eSpark-Consulting-Group/zachary-turner-smart-lighter-hw/docs/Client-Files/Smart Lighter Design.docx

### Detailed Design

1. Clip Attachment:
  - Design: A robust clip mechanism that securely attaches the smart device to the bong’s 14mm or 18mm cylindrical tube just before where the bowl is inserted.
  - Material: Durable, heat-resistant materials such as anodized aluminum or reinforced polymer, ensuring durability and a sleek look.
2. Butane Container:
  - Integration: A cylindrical butane container integrated into the body of the smart device.
  - Safety: Safety valves and pressure release mechanisms to ensure safe operation.
3. Articulated Stove Lighter:
  - Design: A 4-5 inch articulated arm that allows precise control over the flame’s position. The arm is adjustable for optimal user experience. (think of stove lighter) Can also make this location an attachment to potentially swap between different size stove lighter lengths
  - Metal Covering: A larger, spring-loaded metal cover that flips open and closed, similar to mini torches.
  - Dual Function: The metal cover doubles as a tool to extinguish the flame in the bowl if the user needs to put out the cherry.
  - Spring Mechanism: A reliable spring mechanism for smooth operation to flip back and forth from closed/open.
4. Capacitive Touch Sensor:
  - Placement: Integrated into the metal covering of the stove lighter.
  - Functionality: Touching the sensor ignites the flame and emits the butane. Releasing the sensor turns off the flame.
  - Safety: Ensure the capacitive touch sensor is responsive and activates only with intentional touch. (2 second delay?)
5. Binary 10 LED Display:
  - Display Information: Number of puffs or lights of the lighter, battery life, and other information during use through blinking.
  - Placement: Positioned on the body of the smart device for easy visibility.

### Additional Improvements

1. Integrated Features:
  - Status Indicators: LED indicators for butane level, flame activation, and other statuses.
  - Aesthetics: Seamless integration of LEDs to maintain a sleek design.
2. Bluetooth Connectivity (Optional):
  - App Control: (Optional) Allow users to control the lighter and monitor statistics through a smartphone app.
  - Customization: Users can set preferences for flame duration, temperature thresholds, and receive alerts.
3. Rechargeable Battery:
  - Power Source: A rechargeable battery powers the capacitive touch sensor, LCD screen, and other electronic components.
  - Charging Port: Discreet charging port on the device for easy recharging, possibly USB-C for modern compatibility.
4. WaterProof (Optional)

### Step-by-Step Plan for Prototyping

#### 1. Design the Custom Components

- Tip for Lighter Head:
  - Design a threaded fitting that securely attaches to the lighter head.
  - Ensure the fitting matches the threading on the gooseneck tubing and the lighter head.
  - Consider including heat-resistant materials or coatings to handle the lighter's heat.
- Clip:
  - Design the clip that will attach to the bong.
  - Include mounting points for the gooseneck tubing and the custom clamp.
  - Ensure the clip is robust and can securely hold the articulating arm.
- Custom Clamp:
  - Design a clamp that can hold the smooth end of the gooseneck tubing.
  - Ensure the clamp provides a quick-release mechanism for easy detachment and adjustment.
  - Use materials that provide both strength and flexibility.

#### 2. Create Detailed CAD Models

- Use CAD software to create detailed models of the tip, clip, and clamp.
- Ensure all dimensions are accurate and consider any tolerances required for a secure fit.

#### 3. Machining or 3D Printing the Prototypes

- Materials:
  - Use aluminum or stainless steel for durability and heat resistance.
  - Consider 3D printing for initial prototypes to quickly test fit and function before final machining.
- Manufacturing:
  - Machine the components using CNC machining for precision.
  - Alternatively, use 3D printing for the initial prototypes to validate the design.

#### 4. Assembly and Testing

- Assemble the Components:
  - Attach the threaded tip to the lighter head.
  - Secure the gooseneck tubing to the clip using the custom clamp.
  - Ensure all connections are tight and secure.
- Test the Functionality:
  - Verify the stability and flexibility of the articulating arm.
  - Test the lighter head for proper ignition and flame control.
  - Ensure the quick-release mechanism on the clamp functions as expected.
- Validate the Design:
  - Check for any issues with fit, alignment, or interference.
  - Make adjustments to the design as needed based on the testing results.

Given the constraint of only having access to approximately 65% of the circle, we need to ensure the clamp mechanism can securely tighten and hold without requiring access behind the tube. We can use a hinged design with a cam lock or quick-release mechanism integrated into the accessible part of the clamp.

### Clamp Design

#### Key Features

1. Half-Circle Clamp with Extension: Covers approximately 65% of the tube’s circumference.
2. Hinged Design: One side of the clamp is hinged to allow it to open and close around the tube.
3. Cam Lock Lever or Quick-Release Mechanism: Located on the accessible part of the clamp for tightening and releasing.
4. Main Mounting Point For Lighter: This will be the only thing holding and stabilizing the lighter. It will be machined and the butane container will be incorporated into the design.

### Design Components

1. Clamp Body: Anodized aluminum or stainless steel, shaped to cover 65% of the tube’s circumference.
2. Hinge: Allows one side of the clamp to open and close.
3. Protective Inserts: Silicone or rubber inserts to cushion the glass.
4. Cam Lock Lever or Quick-Release Mechanism: For easy tightening and releasing of the clamp.

### Detailed Design Steps

#### 1. Half-Circle Clamp Body

- Shape: A half-circle with an additional extension to cover 65% of the circumference.
- Material: Anodized aluminum or stainless steel.
- Width: Approximately 1 inch for even pressure distribution.

#### 2. Hinge

- Design: A hinge on one side of the clamp to allow it to open and close.
- Material: Stainless steel or similar durable material.

#### 3. Protective Inserts

- Material: Silicone or rubber.
- Placement: Line the inside of the clamp to cushion the glass.

#### 4. Cam Lock Lever or Quick-Release Mechanism

- Location: On the accessible part of the clamp.
- Function: Allows for tightening and securing the clamp around the tube.

### How the Mechanism Works

1. Initial Position:
  - The clamp is open, allowing it to be placed around the glass tube.
  - The hinge allows the clamp to open wide enough to fit around the tube.
2. Engaging the Mechanism:
  - The clamp is closed around the tube.
  - The cam lock lever or quick-release mechanism is engaged to tighten the clamp.
3. Securing the Clamp:
  - The cam lock lever or quick-release mechanism pulls the clamp tight around the tube.
  - The silicone or rubber inserts provide cushioning and a secure grip.
4. Quick Release:
  - To detach, the cam lock lever or quick-release mechanism is released.
  - The hinge allows the clamp to open and be removed easily.

### Example Configuration

1. Clamp Body:
  - Half-circle with an additional 10-15% extension, covering 65% of the tube’s circumference.
  - Width of approximately 1 inch.
2. Inserts:
  - Silicone or rubber lining the inside of the clamp.
3. Hinge:
  - Located on one side of the clamp to allow opening and closing.
4. Cam Lock Lever or Quick-Release Mechanism:
  - Located on the accessible part of the clamp for tightening and releasing.

### Components and Power Consumption

1. ATtiny85 Microcontroller
  - Active Mode: Approximately 5mA at 5V
  - Sleep Mode: Approximately 0.1μA in power-down mode
2. TTP223 Touch Sensor
  - Active Mode: Approximately 3mA at 5V
  - Sleep Mode: Approximately 2.5μA
3. LEDs
  - Forward Voltage (Vf): Approximately 2V
  - Current per LED (I): 10mA (typical)
  - Number of LEDs: 10
4. MAX17043 Battery Monitor
  - Active Mode: Approximately 50μA
  - Sleep Mode: Not significant (consumed with the microcontroller)
1. Active Time:
  - Lighter Usage: 5 seconds
  - Battery Blink: 3 times, each blink 0.25 seconds on and 0.25 seconds off, totaling 1.5 seconds (1.25 seconds on time)
  - Total Active Time per Use: 5 seconds + 1.25 seconds = 6.25 seconds
2. Usage Frequency:
  - Once every 30 to 60 minutes, average every 45 minutes.
  - Active period within a day: 9am to 10pm (13 hours)
3. Daily Activations:
  - Number of activations: 13 hours×60 minutes45 minutes\frac{13 \text{ hours} \times 60 \text{ minutes}}{45 \text{ minutes}}45 minutes13 hours×60 minutes
  - Approximate number of activations: 78045≈17.3\frac{780}{45} \approx 17.345780 ≈17.3

### Power Consumption Calculation

1. Sleep Mode Power Consumption:
  - ATtiny85: 0.1μA
  - TTP223: 2.5μA
  - MAX17043: 50μA
  - Total Sleep Current: 0.1μA+2.5μA+50μA=52.6μA0.1μA + 2.5μA + 50μA = 52.6μA0.1μA+2.5μA+50μA=52.6μA
2. Active Mode Power Consumption:
  - ATtiny85: 5mA
  - TTP223: 3mA
  - MAX17043: 50μA
  - LEDs: 10 LEDs ×\times× 10mA = 100mA
  - Total Active Current: 5mA+3mA+0.05mA+100mA=108.05mA5mA + 3mA + 0.05mA + 100mA = 108.05mA5mA+3mA+0.05mA+100mA=108.05mA
3. Duty Cycle Calculation:
  - Total Active Time per Day: 17.3×6.25 seconds=108.125 seconds17.3 \times 6.25 \text{ seconds} = 108.125 \text{ seconds}17.3×6.25 seconds=108.125 seconds
  - Total Day Time: 13 hours×3600 seconds/hour=46800 seconds13 \text{ hours} \times 3600 \text{ seconds/hour} = 46800 \text{ seconds}13 hours×3600 seconds/hour=46800 seconds
  - Duty Cycle: 108.125 seconds46800 seconds≈0.00231\frac{108.125 \text{ seconds}}{46800 \text{ seconds}} \approx 0.0023146800 seconds108.125 seconds ≈0.00231
4. Average Current Consumption:

Average Current=(Sleep Current×(1−Duty Cycle))+(Active Current×Duty Cycle)\text{Average Current} = (\text{Sleep Current} \times (1 - \text{Duty Cycle})) + (\text{Active Current} \times \text{Duty Cycle})Average Current=(Sleep Current×(1−Duty Cycle))+(Active Current×Duty Cycle) Average Current=(52.6μA×(1−0.00231))+(108.05mA×0.00231)\text{Average Current} = (52.6\text{μA} \times (1 - 0.00231)) + (108.05\text{mA} \times 0.00231)Average Current=(52.6μA×(1−0.00231))+(108.05mA×0.00231) Average Current=(52.6μA×0.99769)+(108.05mA×0.00231)\text{Average Current} = (52.6\text{μA} \times 0.99769) + (108.05\text{mA} \times 0.00231)Average Current=(52.6μA×0.99769)+(108.05mA×0.00231) Average Current=52.48μA+0.249mA=0.30148mA\text{Average Current} = 52.48\text{μA} + 0.249\text{mA} = 0.30148\text{mA}Average Current=52.48μA+0.249mA=0.30148mA

### Battery Life Calculation

#### Using a Coin Cell Battery (CR2032)

- Capacity: 200mAh

Battery Life:

Battery Life=CapacityAverage Current=200mAh0.30148mA≈663 hours≈27.6 days\text{Battery Life} = \frac{\text{Capacity}}{\text{Average Current}} = \frac{200\text{mAh}}{0.30148\text{mA}} \approx 663\text{ hours} \approx 27.6\text{ days}Battery Life=Average CurrentCapacity =0.30148mA200mAh ≈663 hours≈27.6 days

#### Using a Rechargeable LiPo Battery

- Capacity: 500mAh (example)

Battery Life:

Battery Life=CapacityAverage Current=500mAh0.30148mA≈1658 hours≈69 days\text{Battery Life} = \frac{\text{Capacity}}{\text{Average Current}} = \frac{500\text{mAh}}{0.30148\text{mA}} \approx 1658\text{ hours} \approx 69\text{ days}Battery Life=Average CurrentCapacity =0.30148mA500mAh ≈1658 hours≈69 days

### Conclusion

With the revised usage scenario, the estimated battery life for your device is approximately:

- 27.6 days with a CR2032 coin cell battery.
- 69 days with a 500mAh rechargeable LiPo battery.

These estimates indicate a significant improvement in battery life due to the reduced duty cycle. This approach ensures that the device can operate efficiently with minimal power consumption.

To implement a low-power solution that wakes up the device from sleep mode upon a capacitive touch trigger, displays the next binary value, blinks the battery level, and then goes back to sleep, we need to focus on a few key components and techniques:

1. ATtiny85 Sleep Mode and Wake-Up
2. Capacitive Touch Sensor
3. Battery Monitoring
4. Power Management and LED Control

### Components

1. ATtiny85 Microcontroller
  - Low-power mode: Sleep mode with wake-up on interrupt.
  - Supplier: Digi-Key
2. Capacitive Touch Sensor
  - Example: TTP223 Capacitive Touch Sensor Module
  - Supplier: Amazon (https://www.amazon.com/TTP223-Capacitive-Touch-Sensor-Module/dp/B08BZK4RXK)
3. Battery Monitor
  - Example: MAX17043 LiPo Fuel Gauge
  - Supplier: Adafruit
4. LEDs and Resistors
  - 0603 SMD LEDs and 0603 Resistors as previously specified.

### Circuit Design

#### Schematic Diagram

plaintext

Copy code

+Vcc
|
220Ω
|
PB0 ---------- LED1 (Bit 0)
|
GND

+Vcc
|
220Ω
|
PB1 ---------- LED2 (Bit 1)
|
GND

... Continue for all 10 LEDs

+Vcc
|
220Ω
|
PB9 ---------- LED10 (Bit 9)
|
GND

ATtiny85 Pins:
- PB0
- PB1
- PB2
- PB3
- PB4
- PB5
- PB6
- PB7
- PB8
- PB9

TTP223 Touch Sensor:
- OUT -> ATtiny85 PB3 (Interrupt pin)
- VCC -> VCC
- GND -> GND

MAX17043 Fuel Gauge:
- SCL -> ATtiny85 PB4 (I2C SCL)
- SDA -> ATtiny85 PB5 (I2C SDA)
- VCC -> VCC
- GND -> GND

### Example Code (Arduino for ATtiny85)

Simple Arduino sketch to implement sleep mode, capacitive touch wake-up, and battery monitoring:

#include <avr/sleep.h>
#include <avr/interrupt.h>
#include <Wire.h>
#include <Adafruit_MAX17043.h>

#define TOUCH_PIN PB3
#define LED_PIN_START PB0
#define LED_COUNT 10

Adafruit_MAX17043 lipo = Adafruit_MAX17043();

volatile bool touchDetected = false;
volatile uint16_t counter = 0;

void setup() {
// Initialize LEDs
for (uint8_t i = 0; i < LED_COUNT; i++) {
pinMode(LED_PIN_START + i, OUTPUT);
digitalWrite(LED_PIN_START + i, LOW);
}

// Initialize touch sensor pin
pinMode(TOUCH_PIN, INPUT);
attachInterrupt(digitalPinToInterrupt(TOUCH_PIN), wakeUp, RISING);

// Initialize battery monitor
Wire.begin();
if (!lipo.begin()) {
while (1); // Hang if MAX17043 not found
}
lipo.reset();
}

void loop() {
if (touchDetected) {
touchDetected = false;

// Display binary value
displayBinary(counter);
delay(1000); // Display for 1 second

// Blink battery level
float voltage = lipo.cellVoltage();
int batteryPercentage = lipo.cellPercent();
blinkBatteryLevel(batteryPercentage);

// Increment counter
counter++;

// Turn off LEDs
for (uint8_t i = 0; i < LED_COUNT; i++) {
digitalWrite(LED_PIN_START + i, LOW);
}

// Go to sleep
enterSleep();
}
}

void displayBinary(uint16_t number) {
for (uint8_t i = 0; i < LED_COUNT; i++) {
digitalWrite(LED_PIN_START + i, (number >> i) & 0x01);
}
}

void blinkBatteryLevel(int percentage) {
int blinkCount = map(percentage, 0, 100, 1, 10);
for (int i = 0; i < blinkCount; i++) {
for (uint8_t j = 0; j < LED_COUNT; j++) {
digitalWrite(LED_PIN_START + j, HIGH);
}
delay(250);
for (uint8_t j = 0; j < LED_COUNT; j++) {
digitalWrite(LED_PIN_START + j, LOW);
}
delay(250);
}
}

void enterSleep() {
set_sleep_mode(SLEEP_MODE_PWR_DOWN);
sleep_enable();
sleep_mode();
sleep_disable();
sei(); // Ensure interrupts are enabled after waking up
}

void wakeUp() {
touchDetected = true;
}

### Explanation

1. Touch Sensor Interrupt:
  - The TTP223 touch sensor triggers an interrupt on the ATtiny85 when touched, waking it from sleep mode.
2. Sleep Mode:
  - The ATtiny85 enters a low-power sleep mode to conserve energy. It wakes up when the touch sensor is triggered.
3. Binary Display and Battery Monitoring:
  - Upon waking up, the ATtiny85 displays the next binary value using the LEDs and blinks the battery level using the MAX17043 fuel gauge.
4. Power Management:
  - After displaying the values, the ATtiny85 turns off the LEDs and goes back to sleep.

### Conclusion

By using a capacitive touch sensor to wake the ATtiny85 from sleep mode and implementing power-efficient battery monitoring, you can significantly extend battery life. This approach ensures the LEDs are only on when necessary, reducing overall power consumption.

### Butane Container and Activation Mechanism

To integrate a butane container into the device and design a mechanism to deliver butane to the end of the stove lighter arm, we need to focus on the following key aspects:

1. Butane Container Design:
  - Machined butane container integrated into the clip.
  - Airtight sealing to prevent leaks.
2. Butane Flow Activation:
  - Mechanism to release butane when the capacitive touch sensor is activated.
  - Valving system to control the butane flow.
3. Delivery to Stove Lighter Arm:
  - Tubing to deliver butane from the container to the stove lighter arm.
  - Ensuring the tubing is flexible and can withstand butane.

### Butane Container Design

#### Material Selection

- Material: Brass or stainless steel (for durability and resistance to butane).
- Manufacturing: Machining to precise dimensions to ensure airtight sealing.

#### Design Features

- Filling Port: A valve to refill the butane container.
- Outlet Port: A controlled valve to release butane to the stove lighter arm.

### Activation Mechanism

#### Valve Options

4. Solenoid Valve:
  - Electrically controlled valve that opens when powered.
  - Example: Miniature solenoid valves for gas applications.
  - Power Supply: Activated by the microcontroller when the capacitive touch sensor is triggered.
5. Mechanical Valve with Servo Motor:
  - A mechanical valve that is turned by a small servo motor.
  - Example: Mini ball valve with micro servo.
  - Power Supply: Controlled by the microcontroller.

### Delivery to Stove Lighter Arm

#### Tubing

- Material: PTFE (Teflon) or other butane-resistant materials.
- Diameter: Small enough to fit within the design constraints but sufficient to deliver the necessary butane flow.

### Prototype Development

1. Machining the Butane Container:
  - Ensure airtight seals.
  - Integrate filling and outlet ports.
2. Integration of Components:
  - Mount the solenoid valve or servo motor and connect it to the butane container.
  - Route the PTFE tubing from the outlet port to the stove lighter arm.
3. Assembly:
  - Assemble the components on a custom PCB.
  - Ensure proper alignment and secure connections for all components.

### Testing and Validation

4. Leak Testing:
  - Test the butane container and tubing for leaks.
  - Ensure the solenoid valve or servo motor operates correctly.
5. Functional Testing:
  - Verify the capacitive touch sensor triggers the butane flow.
  - Ensure the LEDs display the binary count and battery level correctly.
6. Safety Checks:
  - Ensure all components are securely mounted.
  - Verify there are no butane leaks and the device operates safely.

bin

### Steps to Integrate the 3mm Inlet/Outlet Setup

1. Design the Butane Container with Valve:
  - Ensure the butane container has appropriate fittings for the 3mm inlet/outlet valve.
  - Design the container to accommodate the valve securely.
2. Create a Cavity for the PTFE Tubing:
  - Design cavities in the butane container and the stove lighter arm to fit the 3mm OD PTFE tubing snugly.
3. Secure the Tubing with Adhesive:
  - Use a high-strength adhesive to bond the PTFE tubing in place, ensuring an airtight seal.
4. Ensure Proper Valve Operation:
  - Make sure the valve can be controlled electronically and fits into the overall design.

### Detailed Design and Integration

#### 1. Design the Butane Container with Valve

Components Needed:

- Butane Refill Valve: Ensure it has 3mm inlet/outlet fittings.
- PTFE Tubing: 1.5mm ID x 3mm OD.

Design Considerations:

- Include a mounting section for the valve.
- Ensure the container is refillable and airtight.

Design Steps:

5. Create a Mounting Section:
  - Design the butane container with a section to securely mount the refill valve.
  - Include threads or slots to accommodate the valve fittings.
6. Ensure Airtight Seals:
  - Design the container to prevent leaks.
  - Include O-rings or gaskets if necessary.

#### 2. Create a Cavity for the PTFE Tubing

Design the Cavity:

- Create a cavity that runs from the valve outlet to the stove lighter arm.
- Ensure the cavity diameter is slightly smaller than the tubing OD for a snug fit.

3D Printing Tips:

- Use a higher infill percentage for strength.
- Print with PETG or ABS for chemical resistance.

Assembly Steps:

7. Print the Butane Container and Lighter Arm:
  - 3D print the designed parts with the cavities for the tubing.
8. Insert the PTFE Tubing:
  - Insert the tubing into the cavities.
  - Ensure it fits snugly and reaches the correct positions.

#### 3. Secure the Tubing with Adhesive

Adhesive Selection:

- Use a high-strength adhesive compatible with PTFE and the 3D printed material.
- Example: Loctite 454 or similar.

Bonding Process:

9. Prepare the Surfaces:
  - Clean the surfaces of the cavity and the tubing.
  - Roughen the PTFE tubing surface if needed.
10. Apply the Adhesive:
  - Apply adhesive to the cavity and the end of the tubing.
  - Insert the tubing into the cavity and hold until the adhesive sets.
11. Ensure Airtight Seal:
  - Check the seal by performing a leak test using soapy water.

#### 4. Ensure Proper Valve Operation

Electronic Control:

- Plan to control the valve using a microcontroller.
- Include a MOSFET or similar to switch the valve on and off.

Valve Integration:

- Ensure the valve fits within the overall design and does not interfere with other components.
- Verify that the valve opens and closes properly.

### Example Layout

Here’s a simplified layout for integrating the valve and tubing:

+---------------------+
| Butane Container |
| |
| +--------------+ |
| | Refill Valve | |
| | (3mm I/O) | |
| +------+-------+ |
| | |
+--------|------------+
|
PTFE Tubing (1.5mm ID x 3mm OD)
|
|
V
Stove Lighter Arm
|
Cavity for PTFE Tubing
|
Burner Tip

### Conclusion

By designing the butane container and stove lighter arm to accommodate 3mm inlet/outlet fittings and PTFE tubing, and securing the tubing with high-strength adhesive, you can create a functional and reliable prototype. This setup will ensure proper butane flow and control.

### Solutions for Attaching 3mm OD Tubing to 3mm OD Refill Valve

1. Use a Small Section of Larger Tubing as a Sleeve:
  - Use a small section of tubing with a slightly larger inner diameter as a sleeve to join the 3mm OD tubing and the refill valve.
2. Heat Shrink Tubing:
  - Use heat shrink tubing to create a tight, secure connection.
3. Custom Machined Coupler:
  - Create a custom coupler that fits both the 3mm OD tubing and valve.

### 1. Using Larger Tubing as a Sleeve

Materials Needed:

- A short section of flexible tubing with an ID slightly larger than 3mm (e.g., 4mm ID silicone tubing).

Steps:

4. Cut a short section (about 1-2 cm) of the larger tubing.
5. Slide one end of the larger tubing over the refill valve.
6. Insert the 3mm OD PTFE tubing into the other end of the larger tubing.
7. Secure with hose clamps or adhesive if needed.

### 2. Heat Shrink Tubing

Materials Needed:

- Heat shrink tubing that can fit over both the 3mm OD refill valve and the PTFE tubing.

Steps:

8. Cut a suitable length of heat shrink tubing.
9. Slide the heat shrink tubing over the PTFE tubing.
10. Insert the PTFE tubing into the refill valve.
11. Slide the heat shrink tubing over the junction.
12. Apply heat to shrink the tubing and create a tight seal.

### Example: Using Larger Tubing as a Sleeve

Here’s a detailed approach using larger tubing as a sleeve:

5. Materials:
  - Larger Tubing: Silicone tubing with 4mm ID.
  - PTFE Tubing: 1.5mm ID x 3mm OD PTFE tubing.
  - Refill Valve: 3mm OD refill valve.
  - Hose Clamps or Adhesive: Small hose clamps or high-strength adhesive.
6. Steps:
  a. Cut a 1-2 cm section of 4mm ID silicone tubing.
  b. Slide one end of the silicone tubing over the 3mm OD refill valve.
  c. Insert the 3mm OD PTFE tubing into the other end of the silicone tubing.
  d. Use hose clamps or adhesive to secure the connections if necessary.

### Visual Representation

Here’s a visual representation of the connection using larger tubing as a sleeve:

plaintext

Copy code

+-----------------+
| Refill Valve |
| (3mm OD) |
+--------+--------+
|
+------|------+
| 4mm ID |
| Silicone |
| Tubing |
+------+------+
|
+-------|-------+
| 3mm OD |
| PTFE Tubing |
+---------------+

### Conclusion

Using a short section of larger tubing as a sleeve, heat shrink tubing, or a custom machined coupler are effective methods to securely connect a 3mm OD PTFE tubing to a 3mm OD refill valve. This approach ensures a tight and reliable connection, suitable for handling butane.

### Integrating the Butane Refill Valve

#### Components Needed

1. Butane Refill Valve:
  - This valve will act as the control mechanism for the butane flow.
  - Ensure it is compatible with the butane container and PTFE tubing.
2. Microcontroller and Control Circuit:
  - Use the ATtiny85 microcontroller to control the valve.
  - Include a power transistor or MOSFET to switch the valve on and off.

#### Example Schematic

3. Control Circuit:
  - Use a MOSFET to switch the butane refill valve.
  - Control the MOSFET with a digital output pin from the ATtiny85.
4. Power Supply:
  - Ensure the valve operates at the correct voltage (e.g., 5V or 12V).
  - Use a suitable battery or power source to provide the required voltage and current.

#### Example Schematic Diagram

plaintext

Copy code

Butane Container
|
|----+----------------+
| |
Refill Valve ATtiny85
| |
+----+ |
| |
PTFE |
Tubing |
| |
Stove Lighter Arm |
| |
Burner Tip |
|
+-----------------------+
| |
GND MOSFET
(Control)

### Example Code (Arduino for ATtiny85)

Here’s a simple Arduino sketch to control the refill valve:

#include <avr/sleep.h>
#include <avr/interrupt.h>
#include <Wire.h>
#include <Adafruit_MAX17043.h>

#define TOUCH_PIN PB3
#define LED_PIN_START PB0
#define LED_COUNT 10
#define VALVE_PIN PB4 // Pin to control refill valve

Adafruit_MAX17043 lipo = Adafruit_MAX17043();

volatile bool touchDetected = false;
volatile uint16_t counter = 0;

void setup() {
// Initialize LEDs
for (uint8_t i = 0; i < LED_COUNT; i++) {

pinMode(LED_PIN_START + i, OUTPUT);
digitalWrite(LED_PIN_START + i, LOW);
}

// Initialize valve pin
pinMode(VALVE_PIN, OUTPUT);
digitalWrite(VALVE_PIN, LOW);

// Initialize touch sensor pin
pinMode(TOUCH_PIN, INPUT);
attachInterrupt(digitalPinToInterrupt(TOUCH_PIN), wakeUp, RISING);

// Initialize battery monitor
Wire.begin();
if (!lipo.begin()) {
while (1); // Hang if MAX17043 not found
}
lipo.reset();
}

void loop() {
if (touchDetected) {
touchDetected = false;

// Activate refill valve to release butane
digitalWrite(VALVE_PIN, HIGH);

// Display binary value
displayBinary(counter);
delay(5000); // Display for 5 seconds

// Blink battery level
float voltage = lipo.cellVoltage();
int batteryPercentage = lipo.cellPercent();
blinkBatteryLevel(batteryPercentage);

// Increment counter
counter++;

// Turn off LEDs and refill valve
for (uint8_t i = 0; i < LED_COUNT; i++) {
digitalWrite(LED_PIN_START + i, LOW);
}
digitalWrite(VALVE_PIN, LOW);

// Go to sleep
enterSleep();
}
}

void displayBinary(uint16_t number) {
for (uint8_t i = 0; i < LED_COUNT; i++) {
digitalWrite(LED_PIN_START + i, (number >> i) & 0x01);
}
}

void blinkBatteryLevel(int percentage) {
int blinkCount = map(percentage, 0, 100, 1, 10);
for (int i = 0; i < blinkCount; i++) {
for (uint8_t j = 0; j < LED_COUNT; j++) {
digitalWrite(LED_PIN_START + j, HIGH);
}
delay(250);
for (uint8_t j = 0; i < LED_COUNT; i++) {
digitalWrite(LED_PIN_START + j, LOW);
}
delay(250);
}
}

void enterSleep() {
set_sleep_mode(SLEEP_MODE_PWR_DOWN);
sleep_enable();
sleep_mode();
sleep_disable();
sei(); // Ensure interrupts are enabled after waking up
}

void wakeUp() {
touchDetected = true;
}

### Prototype Assembly

5. Design the Butane Container:
  - Include a section to mount the refill valve securely.
  - Ensure the container can be filled and is airtight.
6. Print and Assemble the Clip:
  - 3D print the clip with the integrated butane container and cavities for the tubing.
  - Attach the refill valve to the butane container outlet.
7. Connect the Tubing:
  - Insert the PTFE tubing into the cavities and secure with adhesive.
  - Connect the tubing from the refill valve to the stove lighter arm.
8. Wiring and Control:
  - Wire the refill valve to the MOSFET and the ATtiny85.
  - Ensure the battery provides sufficient power for the refill valve.
9. Test the System:
  - Test the butane flow and check for leaks.
  - Verify the refill valve opens and closes correctly when activated by the capacitive touch sensor.

### Conclusion

Using the butane refill valve from the provided eBay link, you can create a functional and cost-effective prototype that electronically controls the butane flow. This approach ensures reliable performance and practical integration into your design.

### Attaching the Metal Articulating Arm to the Machined Butane Clip

Objective: Securely attach the metal articulating arm to the machined butane clip while preventing interference with the capacitive touch sensor and ensuring proper routing for the butane tube and igniter wires.

### Components and Layout

1. Machined Butane Clip:
  - Material: Aluminum
  - Design Features: Integrated butane container, mounting points for the articulating arm, space for the capacitive touch sensor, LCD, and PCB.
2. Articulating Arm:
  - Material: Aluminum or stainless steel
  - Design Features: Spring-loaded metal cover, capacitive touch sensor, path for butane tube, and igniter wires.

### Step-by-Step Plan

#### 1. Design the Mounting Interface

- Mounting Points: Design threaded holes or mounting brackets on the machined butane clip to attach the articulating arm securely.
- Insulation: Use non-conductive bushings or washers at the mounting points to electrically isolate the articulating arm from the butane clip. This prevents interference with the capacitive touch sensor.

#### 2. Integrate the Capacitive Touch Sensor

- Sensor Placement: Place the capacitive touch sensor on the articulating arm's metal cover.
- Wiring: Route the sensor wire through an insulated path to the PCB inside the butane clip.

#### 3. Route the Butane Tube and Igniter Wires

- Butane Tube:
  - Use a flexible, heat-resistant butane tube.
  - Ensure the tube runs from the butane container inside the clip through the articulating arm to the end of the lighter.
  - Use grommets or bushings at entry and exit points to prevent wear and tear on the tube.
- Igniter Wires:
  - Use insulated wires to connect the electric igniter to the PCB.
  - Route the wires alongside the butane tube through the articulating arm.
  - Secure the wires with clips or heat-resistant sleeves to prevent movement and potential damage.

#### 4. Electric Igniter Integration

- Igniter Choice: Use a small, reliable electronic igniter module.
- Placement: Position the igniter near the butane outlet at the end of the articulating arm.
- Connection: Connect the igniter wires to the PCB, ensuring a reliable electrical connection.

### Detailed Design Steps

3. CAD Design:
  - Create a detailed CAD model of the butane clip and articulating arm, including all mounting points, paths for the butane tube, and wiring channels.
  - Incorporate the capacitive touch sensor placement and ensure insulation from the clip.
4. Prototyping:
  - Machine the butane clip from aluminum, incorporating the designed features.
  - Fabricate the articulating arm with the metal cover and integrate the capacitive touch sensor.
  - Assemble the components and ensure proper alignment and insulation.
5. Testing:
  - Test the capacitive touch sensor for reliable operation without interference.
  - Ensure the butane tube and igniter wires are securely routed and do not interfere with the arm's movement.
  - Verify the igniter’s functionality and ensure a reliable spark when the capacitive touch sensor is activated.

To create a detachable arm connection that is cost-effective and easy to implement during the machining process, we can look at commonly available components such as quick-release pins, cam locks, and snap-fit connectors. These components are widely used in various industries and can be easily integrated into your design.

### 1. Quick-Release Pins

Quick-release pins are simple, cost-effective, and reliable for detachable connections. They allow for easy attachment and detachment with minimal effort.

- Example Product: Ball Lock Pin or Lynch Pin
  - Features: Available in various sizes, easy to use, provides secure fastening.
  - Cost: Typically $1 - $3 per pin.

#### Implementation

1. Design Mounting Holes:
  - Machine corresponding holes in the clip and the articulating arm to fit the diameter of the quick-release pin.
2. Insert Quick-Release Pin:
  - Align the holes and insert the pin to secure the arm.
  - To detach, simply pull the pin out.

### 2. Cam Locks

Cam locks provide a secure, quick-release mechanism that can be easily machined into the design.

- Example Product: Cam Lock Fastener
  - Features: Simple rotation mechanism to lock and unlock, available in various sizes.
  - Cost: Typically $3 - $5 per lock.

#### Implementation

3. Design Locking Slots:
  - Machine slots into the clip and corresponding cams on the articulating arm.
4. Install Cam Lock:
  - Insert the cam lock into the arm and rotate it to engage with the slot on the clip.
  - To detach, rotate the cam lock to disengage.

### 3. Snap-Fit Connectors

Snap-fit connectors can provide a low-cost, easy-to-use solution for attaching and detaching components.

- Example Product: Plastic Snap-Fit Connectors or Metal Snap-Fit Clips
  - Features: Flexible tabs that snap into place, can be easily integrated into machined parts.
  - Cost: Typically $0.50 - $2 per connector.

#### Implementation

5. Design Snap-Fit Features:
  - Machine flexible tabs or slots into the clip and the corresponding snap-fit features on the arm.
6. Engage Snap-Fit:
  - Push the arm into the clip until the snap-fit tabs engage with the slots.
  - To detach, press the tabs to release.

### Example Configuration

#### Gooseneck Arm with End Fittings

- Top End Fitting:
  - Attach the stove lighter head to the top end of the gooseneck tubing.
  - Ensure a secure connection, possibly using a threaded fitting or clamp.
- Bottom End Fitting:
  - Attach the bottom end of the gooseneck tubing to the clip.
  - Use a quick-release mechanism or a screw fitting to allow for easy attachment and detachment.

### Key Considerations

1. Flexibility and Strength:
  - Ensure the gooseneck tubing can hold the weight of the stove lighter head and maintain its position during use.
2. Heat Resistance:
  - Verify that the stainless steel tubing can withstand the heat generated by the stove lighter.
3. Secure Connections:
  - Use high-quality fittings to secure the ends of the gooseneck tubing to the clip and the stove lighter head.

### Additional Accessories

4. Heat Shrink Tubing:
  - Use heat shrink tubing to cover the connections and provide additional insulation and protection.
5. Cable Management Clips:
  - Use clips or cable ties to manage the butane tube and electrical wires along the length of the gooseneck tubing.

### Custom Torch Tip Design

To custom design a torch tip that incorporates the necessary components for a torch flame, an electric igniter, and a flip mechanism, we need to focus on several key elements:

1. Torch Tip Design:
  - Design the nozzle to create a high-velocity jet of butane.
  - Include air intake holes to mix air with the butane for a stable torch flame.
2. Electric Igniter Integration:
  - Ensure the igniter can reliably spark the butane-air mixture.
  - Design a cavity or mounting point for the igniter electrode.
3. Flip Mechanism:
  - Design a spring-loaded flip cover to protect the torch tip when not in use.
  - Ensure the cover is durable and can double as a tool to extinguish the flame if needed.

### Detailed Configuration

#### 1. Torch Tip

Components:

- Material: Brass or stainless steel.
- Orifice Diameter: Typically around 0.5mm to 1mm for a focused flame.
- Air Intake Holes: 4-6 holes, each around 1mm in diameter.

Design Features:

- Conical Shape: Helps to focus the flame.
- Threaded Base: To screw onto the gooseneck tube.

#### 2. Electric Igniter

Components:

- Piezoelectric Igniter or Electronic Spark Igniter:
  - Ensure it can produce a spark across a gap in the butane-air mixture.
- Electrode Placement:
  - Position the electrode near the nozzle to ignite the butane.

Design Features:

- Electrode Holder: Integrated into the torch tip design.
- Wiring Channel: Allow for safe routing of the igniter wires.

#### 3. Flip Mechanism

Components:

- Metal Cover: Made of stainless steel or aluminum.
- Spring Mechanism: To allow the cover to flip open and closed.

Design Features:

- Hinge and Spring: Integrated into the torch tip to allow easy flipping.
- Latch Mechanism: To keep the cover securely closed when not in use.

### Recommended CNC Machining Providers

1. CNC Rapid:
  - Specializes in small-batch CNC machining with a focus on rapid prototyping and low-volume production.
  - Advanced CNC machinery and experienced engineers ensure high-quality and precise parts.
  - Offers a wide range of materials and can handle complex designs.
  - CNC Rapid (https://www.cncrapid.com/)
2. Xometry:
  - Offers instant quotes and a network of manufacturing partners.
  - Competitive pricing for small to medium batch sizes.
  - Specializes in CNC machining, 3D printing, and injection molding.
  - Xometry (https://www.xometry.com/)
3. Protolabs:
  - Known for fast turnaround times and no minimum order quantities.
  - Ideal for prototypes and small production runs.
  - Protolabs (https://www.protolabs.com/)

### Cost Considerations

4. Material Costs:
  - Materials like aluminum and brass are commonly used for their machinability and cost-effectiveness.
  - Example costs per block: Aluminum 6061 (~~$25), Brass (~~$40).
5. Setup and Machining Time:
  - Setup costs for CNC machining are typically fixed, making small batches more expensive per unit compared to large batches.
  - Machining costs vary by location and complexity, averaging around $30-$50 per hour for 3-axis machining.
6. Tooling and Labor:
  - Tooling costs can be spread over the batch size to reduce per-unit costs.
  - Labor costs are generally part of the setup fee, and efficient design can reduce additional labor requirements.

### Example Cost Breakdown for 15 Pieces

Assuming a simple brass torch tip design:

- Material Cost: $40 (Brass for 15 pieces)
- Setup Cost: $100 (fixed)
- Machining Time: 3 hours at $30/hour ($90)
- Tooling Cost: $20
- Total Cost: $250 for 15 pieces
- Cost per Piece: $250 / 15 = ~$16.67

### Tips for Cost Reduction

- Optimize Design: Simplify the design to reduce machining time.
- Batch Size: Ordering slightly larger batches can significantly reduce per-unit costs.
- Material Selection: Choose materials that are easier to machine and more cost-effective.
