eSpark-Consulting-Group/zachary-turner-smart-lighter-hw/Design-Files/Smart-Lighter-Main-PCB-v1.1/Deliverables/Rendering/3D_Bottom_View.PNG

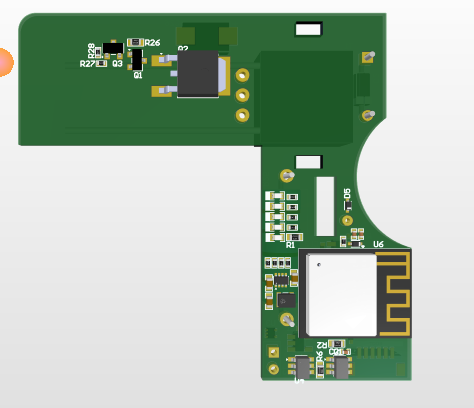
Design-Files/Smart-Lighter-Main-PCB-v1.1/Deliverables/Rendering/3D_Bottom_View.PNG
