eSpark-Consulting-Group/zachary-turner-smart-lighter-hw/Design-Files/Smart-Lighter-Main-PCB-v1.1/Deliverables/Rendering/C_View.PNG

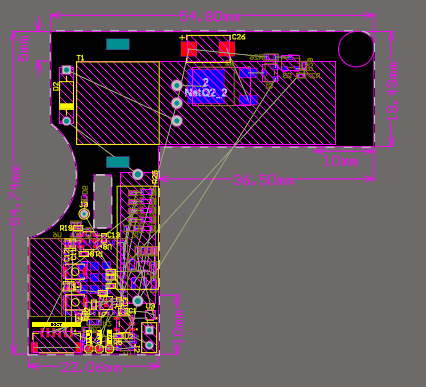
Design-Files/Smart-Lighter-Main-PCB-v1.1/Deliverables/Rendering/C_View.PNG
