eSpark-Consulting-Group/zachary-turner-smart-lighter-hw/docs/Client-Files/Smart Lighter BOM.xlsx

ITEM | DESCRIPTION | MANUFACTURER | PART NO. | SUPPLIER | SUPPLIER PART NO. | PRICE (Approx.) | RoHS
1 | PCB, 4 Layers, 0.062 Thick | Custom | 300300000 | JLCPCB | JLCPCB PCB (https://jlcpcb.com/) | $1.00 | Yes
2 | Pre-assembled PCB Module (ATtiny85, MOSFET, capacitors) | Custom | N/A | Custom Supplier | N/A | $3.00 | Yes
3 | Capacitive Touch Sensor | Azoteq | IQS127D | Digi-Key | IQS127D-ND | $0.50 | Yes
4 | Arc Lighter Module (including battery and recharging module) | Generic | N/A | AliExpress | Arc Lighter Module (https://www.aliexpress.us/item/3256806815670783.html) | $0.99 | Yes
5 | Electrode, Tungsten Rod, 1mm Diameter | McMaster-Carr | 9356T51 | McMaster-Carr | 9356T51 | $0.30 | Yes
6 | High-Temperature PTFE Tubing, 3mm OD | McMaster-Carr | 5236K44 | McMaster-Carr | 5236K44 | $0.20 | Yes
7 | High-Temperature Adhesive | J-B Weld | 37901 | Amazon | B00OTJ6PPC (https://www.amazon.com/J-B-Weld-37901-ExtremeHeat-Temperature/dp/B00OTJ6PPC) | $0.30 (per unit) | Yes
8 | Screws, Bolts, and Nuts | McMaster-Carr | Various | McMaster-Carr | Various | $0.20 | Yes
9 | Butane Refill Nozzle | Colibri | CRF1 | Amazon | B01A7Y5F9S (https://www.amazon.com/Colibri-Butane-Refill-Nozzle/dp/B01A7Y5F9S) | $0.50 | Yes
10 | Silicone for Clamp | Custom | N/A | McMaster-Carr | 9610K56 | $0.20 (per unit) | Yes
11 | Gooseneck Tubing | Custom | N/A | AliExpress | 1600890000000 (https://www.alibaba.com/product-detail/Hot-Sale-Custom-stainless-steel-gooseneck_1600893615579.html) | $0.50 | Yes
12 | Machined Tip and Closing Mechanism | Custom | N/A | Local Machining Service | N/A | $1.00 | Yes
13 | Machined Clamp and Butane/PCB Container | Custom | N/A | Local Machining Service | N/A | $2.00 | Yes
