eSpark-Consulting-Group/zachary-turner-smart-lighter-hw/Design-Files/Secondary-PCB-v1.1/BOM/Client-BOM-Secondary-PCB-v1.0.xlsx

# | Item Type | Designator | Description | Footprint | Manufacturer Part Number | Manufacturer | Value | Quantity | Remarks
1 | Capacitor | C1 | CAP CER 0.1UF 16V X5R 0402 | Cap-0402 | CC0402KRX5R7BB104 | Yageo | 100nF | 1
2 | Capacitor | C2 | CAP CER 10UF 10V X5R 0402 | Cap-0402 | CC0402MRX5R6BB106 | Yageo | 10uF | 1
3 | Capacitor | C3 | CAP CER 22PF 50V C0G/NPO 0402 | Cap-0402 | CC0402JRNPO9BN220 | Yageo | 22PF | 1
4 | Protection Device | D1 | SOD-523 ESD Protection Devices ROHS | SOD-523 | LESD5D5.0CT1G | UMW | - | 1
5 | Press spring | J1 | Press spring | Custom | F9-10-5.5Z | Sam&wing | - | 1
6 | Pin Header | ~~J2~~ | ~~Gold Bend insert Policy 2.5mm 6mm 14P -40℃~+105℃ 2.54mm Brass Double Row Black 2x7P 2.54mm Push-Pull,P=2.54mm Pin Headers ROHS~~ | ~~Custom~~ | ~~P125-1207A0BR138A1~~ | ~~Yxcon~~ | ~~-~~ | ~~1~~ | ~~DO NOT PLACE~~
7 | USB Connector | J3 | 1 Brick nogging 14P Female Type-C SMD USB Connectors ROHS | Custom | TYPE-C-31-D-07 | Korean Hroparts Elec | - | 1
8 | LED | LED1, LED2, LED3, LED4, LED5, LED6, LED7, LED8, LED9, LED10 | blue 0402 Light Emitting Diodes (LED) ROHS | LED-0402 | NCD0402B1 | Foshan NationStar Optoelectronics | - | 10
9 | Resistor | R1, R3, R4, R5, R6, R8, R9, R10, R11, R12 | RES SMD 10 OHM 1% 1/5W 0402 | Res-0402 | CRCW040210R0FKEDHP | Vishay Dale | 10R | 10
10 | Resistor | R2, R7 | RES 0 OHM JUMPER 1/16W 0402 | Res-0402 | RC0402FR-070RL | Yageo | 0R | 2
11 | Resistor | R13, R14 | RES 5.1K OHM 1% 1/16W 0402 | Res-0402 | RC0402FR-075K1L | Yageo | 5.1K | 2
12 | IC | U1 | SOT-23-6L Touch Sensors ROHS | SOT-23-6 | TTP233H-BA6 | Tontek Design Tech | - | 1
