eSpark-Consulting-Group/zachary-turner-smart-lighter-hw/Design-Files/Smart-Lighter-Main-PCB-v1.1/BOM/Client-BOM-Main-PCB-v1.0.xlsx

# | Item Type | Designator | Description | Footprint | Manufacturer Part Number | Manufacturer | Value | Quantity | Remarks
1 | Antenna | ANT1 | 2.4GHZ CERAMIC CHIP ANTENNA | Custom | RFANT3216120A5T | Walsin Technologies | 2.4GHZ | 1
2 | Capacitor | C1 | CAP CER 2.2UF 25V X5R 0402 | Cap-0402 | GRM155R61E225KE11D | Murata | 2.2uf | 1
3 | Capacitor | C2, C10, C12, C13, C17, C18, C19, C27 | CAP CER 0.1UF 16V X5R 0402 | Cap-0402 | CC0402KRX5R7BB104 | Yageo | 100nF | 8
4 | Capacitor | C3, C15, C16 | CAP CER 1UF 16V X5R 0402 | Cap-0402 | CC0402KRX5R7BB105 | Yageo | 1uF | 3
5 | Capacitor | C4, C5, C6 | CAP CER 22UF 10V X5R 0603 | Cap-0603 | CC0603MRX5R6BB226 | Yageo | 22uF | 3
6 | Capacitor | C11 | CAP CER 10UF 10V X5R 0402 | Cap-0402 | CC0402MRX5R6BB106 | Yageo | 10uF | 1
7 | Capacitor | C14 | CAP CER 10000PF 25V X7R 0402 | Cap-0402 | CC0402KRX7R8BB103 | Yageo | 10nF | 1
8 | Capacitor | C20, C21 | CAP CER 22PF 50V C0G/NPO 0402 | Cap-0402 | CC0402JRNPO9BN220 | Yageo | 22PF | 2
9 | Capacitor | C26 | CAP TANT 470UF 10% 10V 2917 | Case-E | TAJE477K010RNJ | Kyocera AVX | 470uF | 1
10 | Diode | D2 | 1.7V@1A 75ns 1A 1kV DO-41 Fast Recovery / High Efficiency Diodes ROHS | DO-41 | UF4007 | MDD(Microdiode Semiconductor) | - | 1
11 | Male Header | ~~J2~~ | ~~Gold 250V 3A Straight Square Pins 2.5mm 2P 260℃ 6mm -40℃~+105℃ 3mm 2.54mm Plugin Black Brass 1x2P Plugin,P=2.54mm Pin Headers ROHS~~ | ~~HDR1X2_~~ | ~~X6511WV-02H-C60D30~~ | ~~XKB~~ | ~~DNP~~ | ~~1~~ | ~~DO NOT PLACE~~
12 | Connector | J3 | 1x6P SH 1 1mm 6 SMD,P=1mm Wire To Board / Wire To Wire Connector ROHS | Custom | C145963 | BOOMELE | - | 1
13 | Pin Header | J4 | Gold Bend insert Policy 2.5mm 6mm 14P -40℃~+105℃ 2.54mm Brass Double Row Black 2x7P 2.54mm Push-Pull,P=2.54mm Pin Headers ROHS | Custom | P125-1207A0BR138A1 | Yxcon | - | 1
14 | Inductor | L1 | FIXED IND 1UH 3.2A 0.042OHM SMD | IND-1008 (2520 Metric) | DFE252012P-1R0M=P2 | Murata | 1uH | 1
15 | Inductor | L3 | FIXED IND 6.8NH 200MA 1.15OHM SM | IND-0201 | LQP03TG6N8H02D | Murata | 6.8nH | 1
16 | Inductor | L4 | FIXED IND 2NH 600MA 100 MOHM SMD | IND-0201 | MLG0603P2N0CT000 | TDK | 2nH | 1
17 | Inductor | L5 | 140mA 24nH ±3% 2.3Ω 0201 Inductors (SMD) ROHS | IND-0201 | LQP03TN24NH02D | Murata | 24nH | 1
18 | LED | LED1 | RED LED 0603 Light Emitting Diodes | LED-0603 | NCD0603R3 | Foshan NationStar Optoelectronics | - | 1
19 | (BJT) | Q1 | TRANS PNP 60V 0.6A TO236AB | SOT-23 | PMBT2907A,215 | Nexperia | - | 1
20 | Mosfet | Q2 | TRANS NPN 60V 10A DPAK | DPAK | MJD3055T4G | ON Semiconductor | - | 1
21 | Mosfet | Q3 | TRANS NPN 40V 0.6A SMD SOT23-3 | SOT-23 | MMBT2222A-7-F | Diodes | - | 1
22 | Resistor | R1, R2, R26 | RES SMD 330R 100 mW 0603 | Res-0603 | RC0603JR-07330RL | Yageo | 330R | 3
23 | Resistor | R5, R23, R24, R35 | RES 4.7K OHM 1% 1/16W 0402 | Res-0402 | RC0402FR-074K7L | Yageo | 4.7K | 4
24 | Resistor | R6 | RES 2.2K OHM 1% 1/10W 0603 | Res-0603 | RC0603FR-072K2L | Yageo | 2.2K | 1
25 | Resistor | R7, R8, R12, R13, R17, R19, R20, R28 | RES 10K OHM 1% 1/16W 0402 | Res-0402 | RC0402FR-0710KL | Yageo | 10K | 8
26 | Resistor | R9 | RES 511K OHM 1% 1/16W 0402 | Res-0402 | RC0402FR-07511KL | Yageo | 511K | 1
27 | Resistor | R14 | RES SMD 91K OHM 0.1% 1/16W 0402 | Res-0402 | RT0402BRD0791KL | Yageo | 91K | 1
28 | Resistor | R18 | RES 499 OHM 1% 1/16W 0402 | Res-0402 | RC0402FR-07499RL | Yageo | 499R | 1
29 | Resistor | R25 | Metal Film Resistors 33Ω 3W ±50ppm/℃ ±1% Plugin,D5xL15.5mm Through Hole Resistors ROHS | Custom | MFR03SF330JA10 | UNI-ROYAL | 33R | 1
30 | Resistor | R27 | RES 680 OHM 1% 1/16W 0402 | Res-0402 | RC0402FR-07680RL | Yageo | 680R | 1
31 | Switch | SW1, SW2 | SWITCH TACTILE SPST-NO 0.05A 12V | Custom | B3U-1000P | Omron | - | 2
32 | Transformer | T1 | 15KV Arc Ignition High Voltage Inverter Step Up Boost Coil Transformer Pulse Ignition 1.4x1.4x0.7cm Lighter Accessories | Custom | 15KV step-up coil transformer | Aideepen | - | 1
33 | IC | U1 | SOT-23-6 Battery Management ROHS | SOT-23-6 | DW01-A/J | Shenzhen Fuman Elec | - | 1
34 | IC | U2 | 4.5V~5.5V 锂离子/Polymer 1 600mA SOT-23-5 Battery Management ICs ROHS | SOT-23-5 | TP4054 | TPOWER | - | 1
35 | IC | U3 | Active Low 1 VSOF-5 Monitors & Reset Circuits ROHS | 5-VSOF | BD4830FVE-TR | Rohm | - | 1
36 | IC | U4 | 20V 6A 22mΩ@4.5V,4.5A 2W 2PCSNChannel(Common Drain) SOT-23-6 MOSFETs ROHS | SOT-23-6 | .8205A | Shenzhen Fuman Elec | - | 1
37 | IC | U5 | Non-Isolated PoL Module DC DC Converter 1 Output 1.2 ~ 5.3V 2A 1.6V - 5.5V Input | SOT-583 | TPS631000DRLR | Texas Instruments | - | 1
38 | IC | U7 | IC BATT MON LI-ION 1CELL 8TDFN | 8-TDFN-EP (2x2) | MAX17048G+T10 | Maxim | - | 1
39 | IC | U8 | RF TXRX MODULE BLUETOOTH SMD | 32-QFN (5x5) | ESP32-C3FH4 | Espressif Systems | - | 1
40 | IC | U10 | 16 400kHz I2C TQFN-24-EP(4x4) I/O Expanders ROHS | TQFN-24-EP(4x4) | AW9523BTQR | AWINIC | - | 1
41 | Crystal | X1 | 40MHz SMD Crystal Resonator 15pF SMD3225-4P Crystals ROHS | Custom | X322540MPB4SI | Yangxing Tech | 40MHz | 1
42 | Peripheral | Battery | 3.7v 803040 1000mah lithium li polymer rechargeable battery for electronic book tablet toys Mobile Pocket replacement batteries | Custom | - | - | - | 1 | Battery (https://vi.aliexpress.com/item/4000939317595.html?gatewayAdapt=glo2vnm)
