eSpark-Consulting-Group/zachary-turner-smart-lighter-hw/Design-Files/Smart-Lighter-Main-PCB-v1.1/Main-PCB-v1.1.step

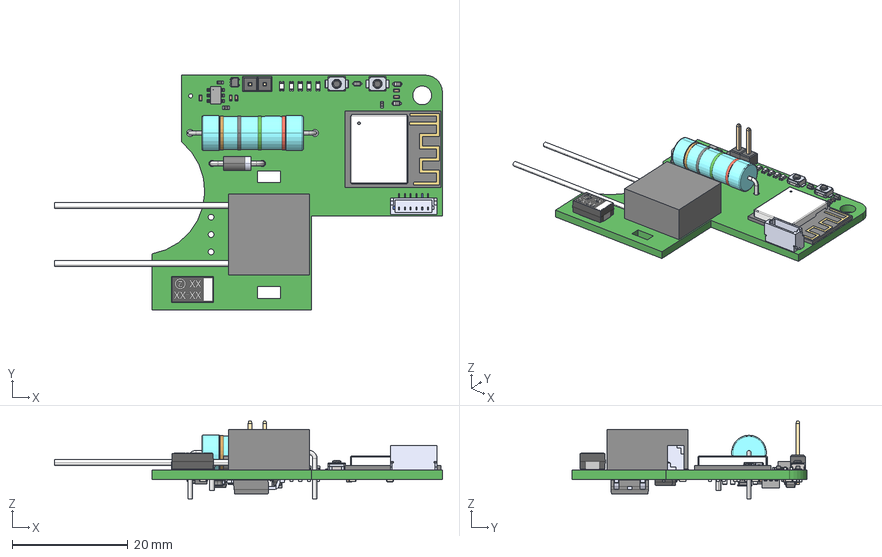
[picture p5: CAD file, 2025-02-06]
Design-Files/Smart-Lighter-Main-PCB-v1.1/Main-PCB-v1.1.step
66.9 x 40.5 x 13.4 mm
DFN1006.STEP(2)^DFN1006.STEP(2)_Submodel-SOD882_part(2)_ DesignRootModel(2)_PCB_ESP32-C3-MINI-1_V1A(2)_PCB_ESP32-C3-MINI-1_V1A
R0201_20210301.STEP(2)^R0201_20210301.STEP(2)_Submodel-R0201_part(2)_ DesignRootModel(2)_PCB_ESP32-C3-MINI-1_V1A(2)_PCB_ESP32-C3-MINI-1_V1A x 3
placementOutline(2)^Submodel-noModelForPart_MINI-ANT-TYPED-H_ 1968823293(2)_Submodel-MINI-ANT-TYPED-H_1968823293_part(2)_ DesignRootModel(2)_PCB_ESP32-C3-MINI-1
placementOutline-0(2)^Submodel-noModelForPart_MINI-ANT-TYPED-H_ 1968823293(2)_Submodel-MINI-ANT-TYPED-H_1968823293_part(2)_ DesignRootModel(2)_PCB_ESP32-C3-MINI
placementOutline-1(2)^Submodel-noModelForPart_MINI-ANT-TYPED-H_ 1968823293(2)_Submodel-MINI-ANT-TYPED-H_1968823293_part(2)_ DesignRootModel(2)_PCB_ESP32-C3-MINI
placementOutline-2(2)^Submodel-noModelForPart_MINI-ANT-TYPED-H_ 1968823293(2)_Submodel-MINI-ANT-TYPED-H_1968823293_part(2)_ DesignRootModel(2)_PCB_ESP32-C3-MINI
placementOutline-3(2)^Submodel-noModelForPart_MINI-ANT-TYPED-H_ 1968823293(2)_Submodel-MINI-ANT-TYPED-H_1968823293_part(2)_ DesignRootModel(2)_PCB_ESP32-C3-MINI
placementOutline-4(2)^Submodel-noModelForPart_MINI-ANT-TYPED-H_ 1968823293(2)_Submodel-MINI-ANT-TYPED-H_1968823293_part(2)_ DesignRootModel(2)_PCB_ESP32-C3-MINI
placementOutline-5(2)^Submodel-noModelForPart_MINI-ANT-TYPED-H_ 1968823293(2)_Submodel-MINI-ANT-TYPED-H_1968823293_part(2)_ DesignRootModel(2)_PCB_ESP32-C3-MINI
trace_4(2)^Submodel-MINI-ANT-TYPED-H_1968823293_part(2)_ DesignRootModel(2)_PCB_ESP32-C3-MINI-1_V1A(2)_PCB_ESP32-C3-MINI-1_V1A
trace_1(2)^Submodel-MINI-ANT-TYPED-H_1968823293_part(2)_ DesignRootModel(2)_PCB_ESP32-C3-MINI-1_V1A(2)_PCB_ESP32-C3-MINI-1_V1A
C0402_20210301.STEP(2)^C0402_20210301.STEP(2)_Submodel-C0402_part(2)_ DesignRootModel(2)_PCB_ESP32-C3-MINI-1_V1A(2)_PCB_ESP32-C3-MINI-1_V1A
C0201_20210301.STEP(2)^C0201_20210301.STEP(2)_Submodel-C0201_part(2)_ DesignRootModel(2)_PCB_ESP32-C3-MINI-1_V1A(2)_PCB_ESP32-C3-MINI-1_V1A x 11
L0201_20210301.STEP(2)^L0201_20210301.STEP(2)_Submodel-L0201_part(2)_ DesignRootModel(2)_PCB_ESP32-C3-MINI-1_V1A(2)_PCB_ESP32-C3-MINI-1_V1A x 2
XTAL3225_20210301.STEP(2)^XTAL3225_20210301.STEP(2)_Submodel-XTAL3225_ part(2)_DesignRootModel(2)_PCB_ESP32-C3-MINI-1_V1A(2)_PCB_ ESP32-C3-MINI-1_V1A
ESP32-C3_20210301.STEP(2)^ESP32-C3_20210301.STEP(2)_Submodel-QFN32_0P5_ 5_part(2)_DesignRootModel(2)_PCB_ESP32-C3-MINI-1_V1A(2)_PCB_ ESP32-C3-MINI-1_V1A
uid__2428(2)^DesignRootModel(2)_PCB_ESP32-C3-MINI-1_V1A(2)_PCB_ ESP32-C3-MINI-1_V1A
ShieldBox_ESP32-C3-MINI-1_V1.0_20200901
solder_pad
User Library-RES_1005-0402 x 20
User Library-LED SMD0603 x 5
User Library-SOD-523F x 4
User Library-Capacitor 0402 x 10
21-0058I_MXM x 3
21-0168E_T822-1_MXM
Open_CASCADE_STEP_translator_6.8_10.1
Open_CASCADE_STEP_translator_6.8_10.2.1
lead x 5
SN74LV1T34DBVR
15KV Arc Ignition High Voltage (1)
User Library-OMRON B3U1000P x 2
User Library-RESC1608X05N x 4
CircuitWorks-SOT-23 x 2
MC7805BDTRKG
VLS252012HBX-100M
User Library-Header1x2_Header1_1 x 2
SOLID.step.STEP.dwg.STEP.STEP.dwg
SOLID.step
593D D-CASE
User Library-CAPC1608X09 x 3
