eSpark-Consulting-Group/zachary-turner-smart-lighter-hw/docs/Dev-Files/Enclosure-Files/Main PCB 7.3 Lighter.DXF

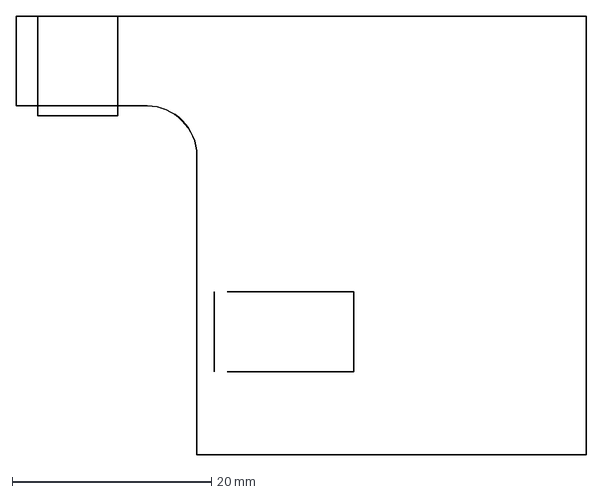
[picture p6: CAD file, 2025-04-08]
docs/Dev-Files/Enclosure-Files/Main PCB 7.3 Lighter.DXF
57.2 x 44.0 mm
