eSpark-Consulting-Group/zachary-turner-smart-lighter-hw/Design-Files/Secondary-PCB-v1.1/Supporting Files/Secondary-PCB-v1.1.step

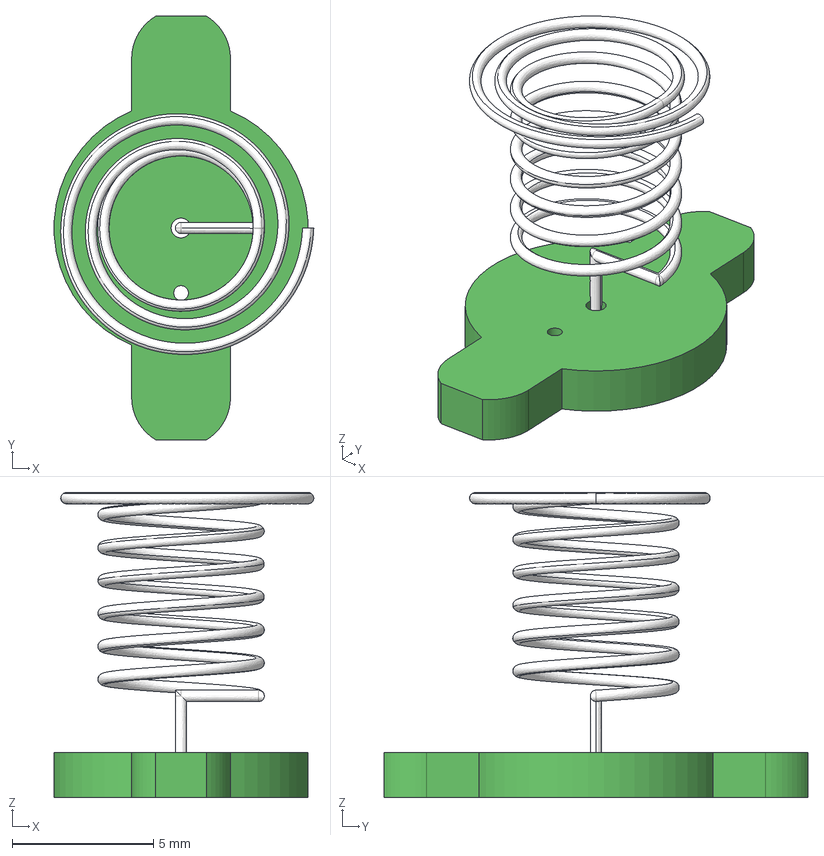
[picture p7: CAD file, 2025-02-21]
Design-Files/Secondary-PCB-v1.1/Supporting Files/Secondary-PCB-v1.1.step
9.19 x 15.0 x 10.8 mm
F9-10-5.5Z
