eSpark-Consulting-Group/zachary-turner-smart-lighter-hw/docs/Dev-Files/Step_file/Secondary_PCB.step

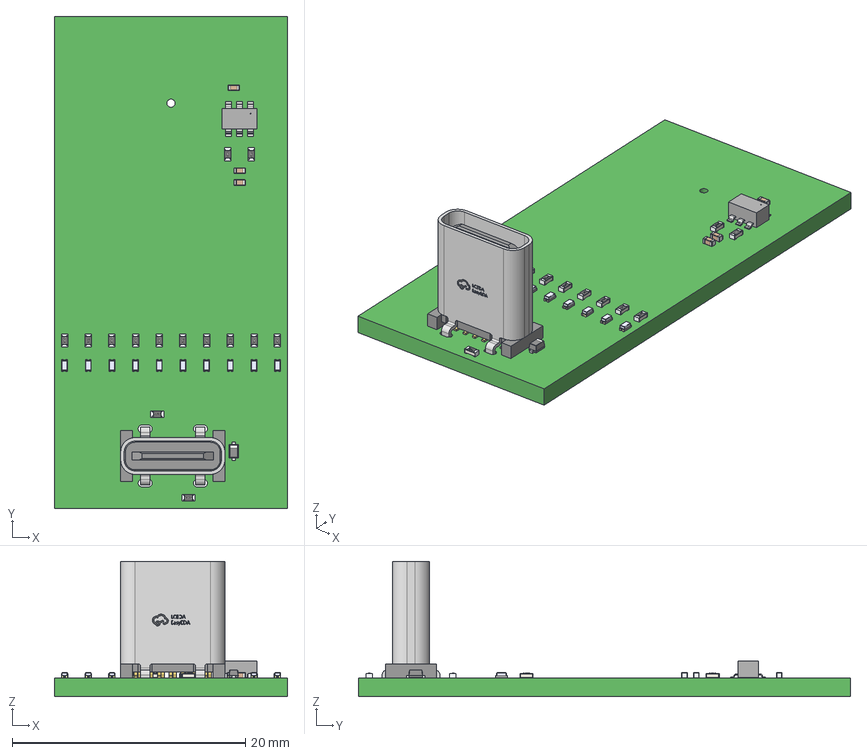
[picture p8: CAD file, 2024-09-10]
docs/Dev-Files/Step_file/Secondary_PCB.step
20.0 x 42.2 x 11.6 mm
TYPE-C-31-D-07-1
User Library-RES_1005-0402 x 14
User Library-SOD-523F
21-0058I_MXM
User Library-LED-0402 x 10
User Library-Capacitor 0402 x 3
