eSpark-Consulting-Group/zachary-turner-smart-lighter-hw/docs/Dev-Files/Step_file/Smart-Lighter-v1.0.step

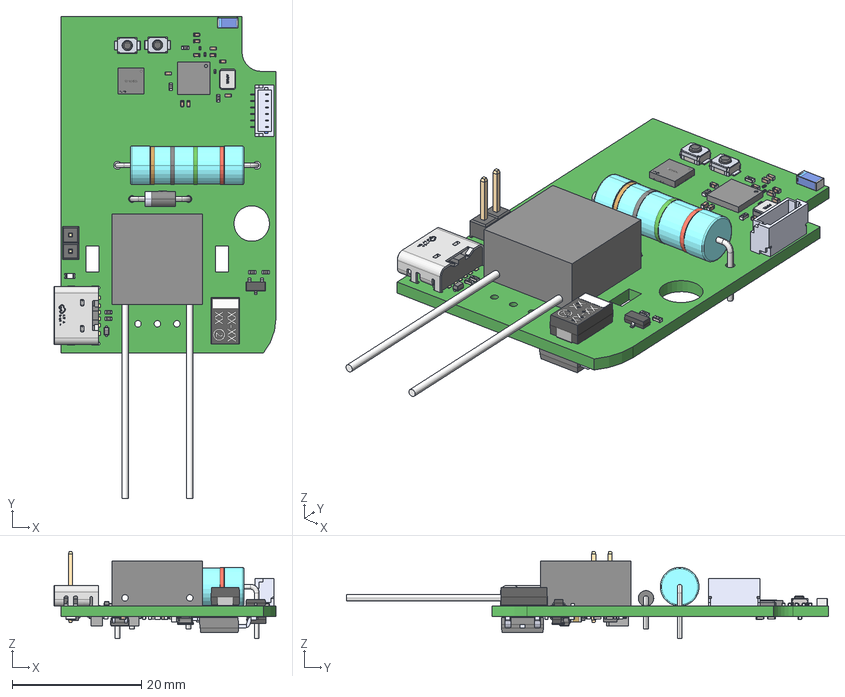
[picture p9: CAD file, 2024-09-06]
docs/Dev-Files/Step_file/Smart-Lighter-v1.0.step
34.3 x 74.5 x 13.4 mm
User Library-Capacitor 0402 x 16
ABM8-24.000MHZ-R60-D-1-W-T
User Library-QFN-32-5x5 - EQ
21-0168E_T822-1_MXM
21-0058I_MXM x 2
Open_CASCADE_STEP_translator_6.8_10.1
Open_CASCADE_STEP_translator_6.8_10.2.1
lead x 5
SN74LV1T34DBVR
15KV Arc Ignition High Voltage (1)
User Library-OMRON B3U1000P x 2
User Library-RES_1005-0402 x 18
User Library-RESC1608X05N x 4
CircuitWorks-SOT-23 x 2
MC7805BDTRKG
User Library-LED SMD0603
Ferrite x 3
VLS252012HBX-100M
SOLID.step.STEP.dwg.STEP.STEP.dwg
User Library-Header1x2_Header1_1 x 2
COMPOUND.step
SOLID.step
User Library-SOD-523F
593D D-CASE
User Library-CAPC1608X09 x 3
