eSpark-Consulting-Group/zachary-turner-smart-lighter-hw/(list of files, cad)

Other CAD files:
docs/Dev-Files/DXF_for_Secondary_PCB/electrical compartment version 5.DXF
Design-Files/Secondary-PCB-v1.1/Supporting Files/Secondary-PCB-v1.1.DWG
Design-Files/Secondary-PCB-v1.1/Supporting Files/Secondary-PCB-v1.1.DXF
Design-Files/Smart-Lighter-Main-PCB-v1.1/Deliverables/Supporting Files/Main-PCB-v1.1.DWG
Design-Files/Smart-Lighter-Main-PCB-v1.1/Deliverables/Supporting Files/Main-PCB-v1.1.DXF
