eSpark-Consulting-Group/zachary-turner-smart-lighter-hw/Design-Files/Smart-Lighter-Main-PCB-v1.1/Schematic/Main-PCB-v1.1.pdf

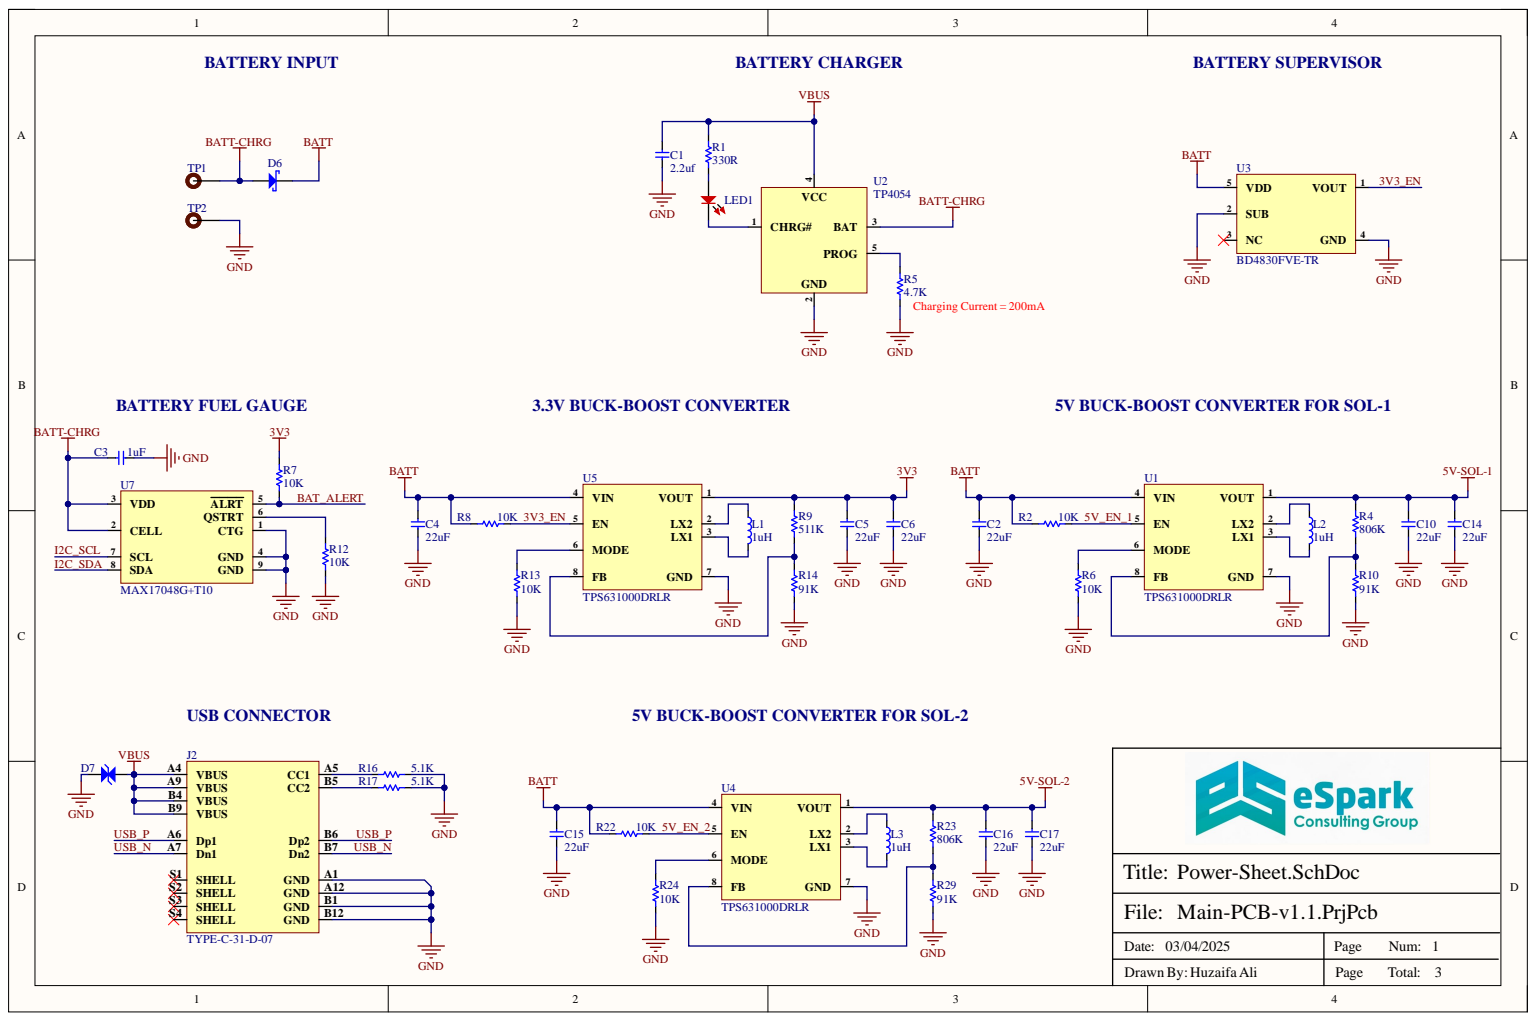
[picture p10: page 1]

5V BUCK-BOOST CONVERTER FOR SOL-1

5V BUCK-BOOST CONVERTER FOR SOL-2

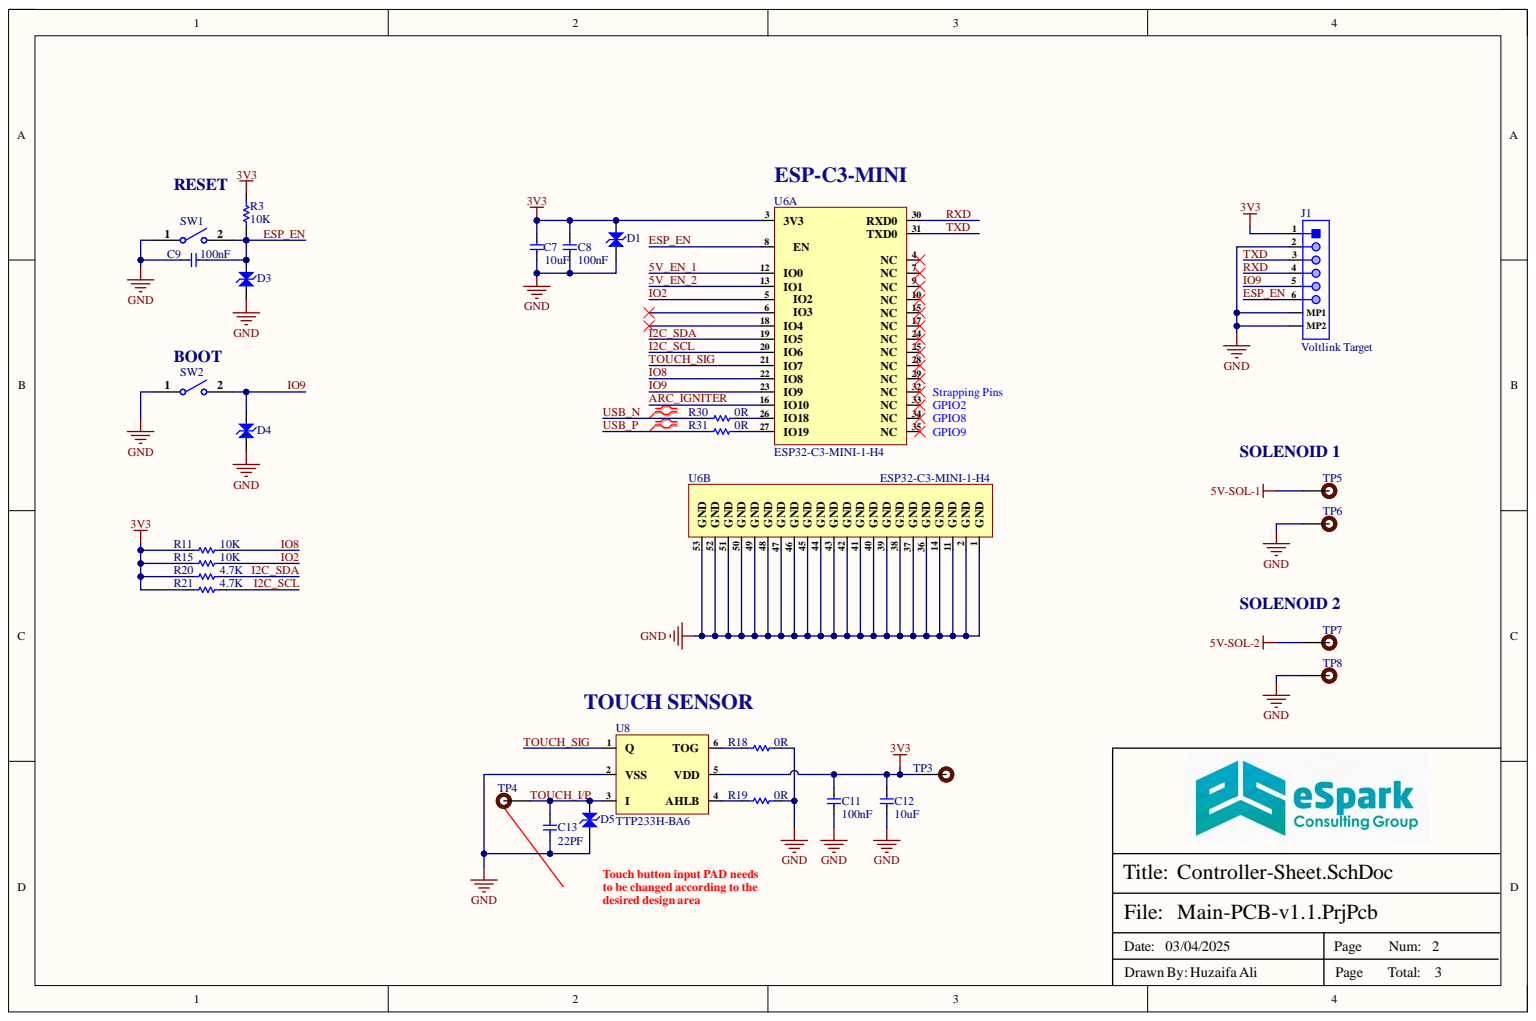
[picture p11: page 2]

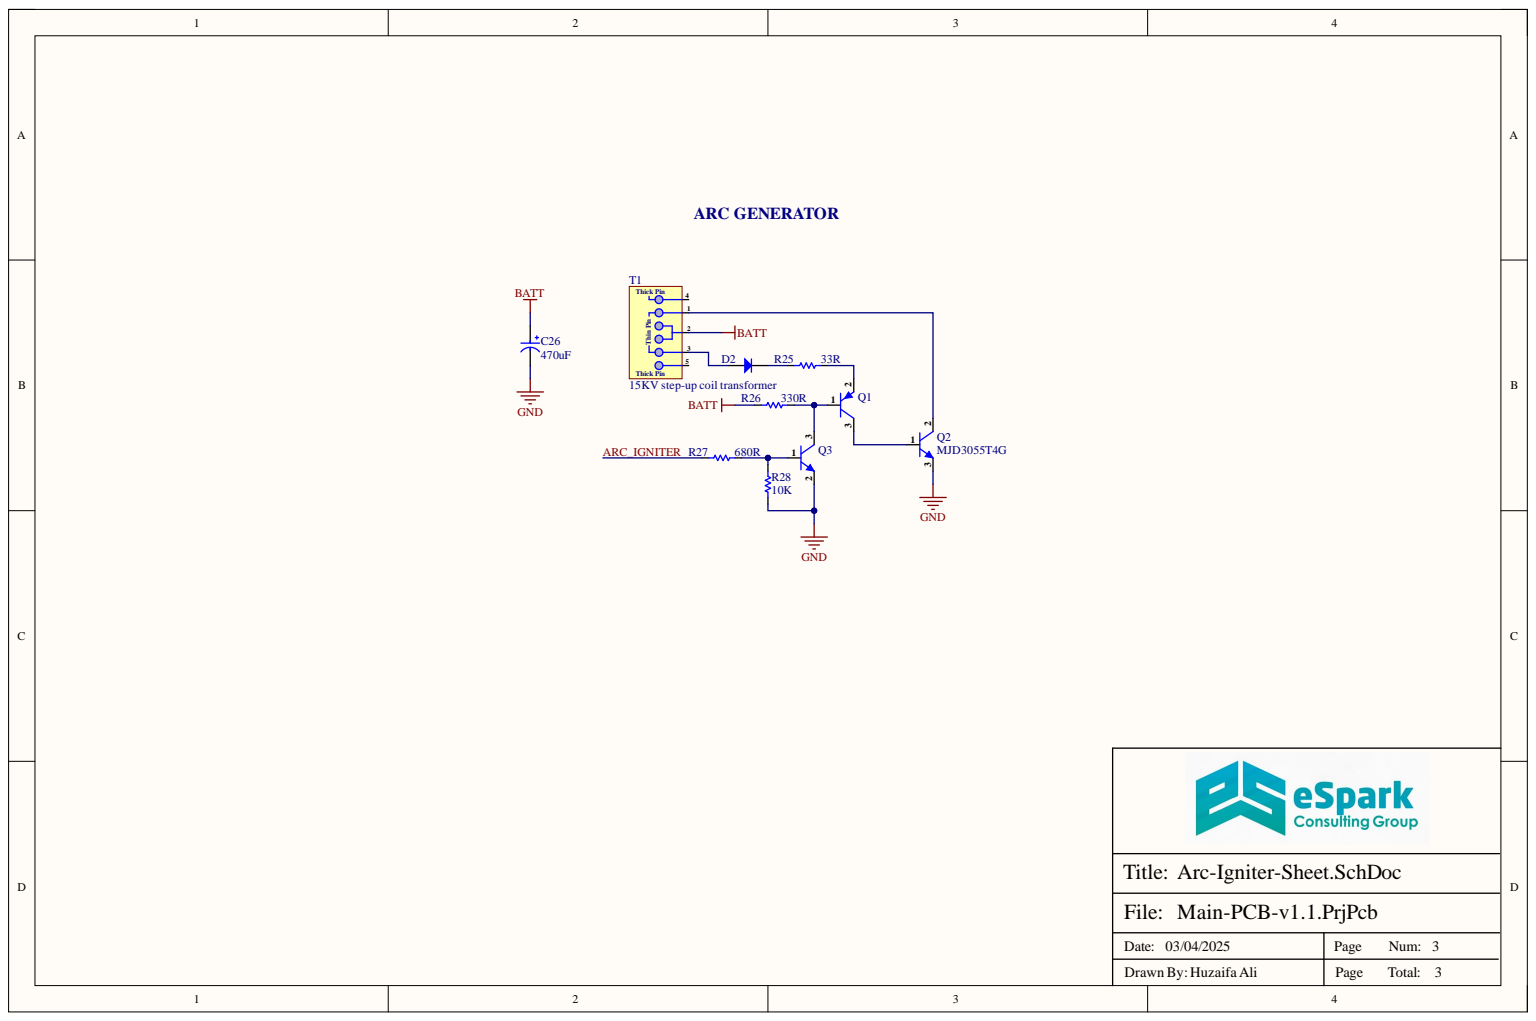
[picture p12: page 3]
