eSpark-Consulting-Group/zachary-turner-smart-lighter-hw/(list of files, drawings)

Other design files:
Design-Files/Secondary-PCB-v1.1/Secondary-PCB-v1.1.PcbDoc
Design-Files/Secondary-PCB-v1.1/Secondary-PCB-v1.1.PrjPcb
Design-Files/Secondary-PCB-v1.1/Touch-Button-Sheet.SchDoc
Design-Files/Smart-Lighter-Main-PCB-v1.1/Arc-Igniter-Sheet.SchDoc
Design-Files/Smart-Lighter-Main-PCB-v1.1/Controller-Sheet.SchDoc
Design-Files/Smart-Lighter-Main-PCB-v1.1/Main-PCB-v1.1.PcbDoc
Design-Files/Smart-Lighter-Main-PCB-v1.1/Main-PCB-v1.1.PrjPcb
Design-Files/Smart-Lighter-Main-PCB-v1.1/Power-Sheet.SchDoc
Design-Files/Smart-Lighter-v1.0/Main-PCB-v1.0/Main-PCB-v1.0.PrjPcb
Design-Files/Smart-Lighter-v1.0/Main-PCB-v1.0/Smart-Lighter-v1.0.PrjPcb
Design-Files/Smart-Lighter-v1.0/Secondary-PCB-v1.0/Secondary-PCB-v1.0.PrjPcb
