eSpark-Consulting-Group/zachary-turner-smart-lighter-hw/(commit log)

2024-07-03 gitignore added. Client files added
    [Smart Lighter BOM.xlsx]
2024-07-11 #1 Power Sheet added
    [Power-Sheet.SchDoc, Smart-Lighter-v1.0.PrjPcb]
2024-07-12 #1 First schematic draft complete
    [Arc-Igniter-Sheet.SchDoc, Controller-Sheet.SchDoc, LED-Sheet.SchDoc, Power-Sheet.SchDoc, Smart-Lighter-v1.0.PrjPcb]
2024-07-15 #1 Q1 transistor updated. PDF updated
    [Arc-Igniter-Sheet.SchDoc, Controller-Sheet.SchDoc]
2024-07-26 #2 Client BOM added
    [Client-BOM-Smart-Lighter-v1.0.xlsx]
2024-08-28 #1 schematic changes done #3 Placement in progress
    [Controller-Sheet.SchDoc, Power-Sheet.SchDoc, Smart-Lighter-v1.0.PcbDoc, Smart-Lighter-v1.0.PrjPcb]
2024-08-29 #3 Placement in progress
    [Smart-Lighter-v1.0.PcbDoc]
2024-09-02 #3 Placement completed #4 schematic done,Touch button remaining
    [Secondary_PCB.PrjPcb, Smart-Lighter-v1.0.PcbDoc, Touch_Button_Sheet.SchDoc]
2024-09-04 #3 routing in progress
    [Controller-Sheet.SchDoc, LED-Sheet.SchDoc, Power-Sheet.SchDoc, Smart-Lighter-v1.0.PcbDoc]
2024-09-05 #4 button updated placement in progress #3 Placement in progress
    [Secondary_PCB.PcbDoc, Secondary_PCB.PrjPcb, Smart-Lighter-v1.0.PcbDoc, Touch_Button_Sheet.SchDoc]
2024-09-06 #3 PCB in progress
    [Secondary_PCB.PcbDoc, Secondary_PCB.step, Smart-Lighter-v1.0.PcbDoc, Smart-Lighter-v1.0.step]
2024-09-09 #4 Secondary PCB updated acc to DXF provided from Mech:team
    [Secondary_PCB.PcbDoc, Secondary_PCB.step, electrical compartment version 5.DXF]
2024-09-10 #4 USB added and leds size reduced # usb removed from main board
    [Power-Sheet.SchDoc, Secondary_PCB.PcbDoc, Secondary_PCB.step, Touch_Button_Sheet.SchDoc]
2024-10-21 File ordering and versioning updated
    [Arc-Igniter-Sheet.SchDoc, Client-BOM-Smart-Lighter-v1.0.xlsx, Controller-Sheet.SchDoc, LED-Sheet.SchDoc, Power-Sheet.SchDoc, Secondary-PCB-v1.0.PcbDoc, Secondary-PCB-v1.0.PrjPcb, Smart-Lighter-v1.0.PcbDoc]
2024-10-21 #2 Client BOM Update.
    [Client-BOM-Main-PCB-v1.0.xlsx, Client-BOM-Secondary-PCB-v1.0.xlsx, Client-BOM-Smart-Lighter-v1.0.xlsx, Main-PCB-v1.0.PrjPcb, Main_PCB-v1.0.PcbDoc, Secondary-PCB-v1.0.PrjPcb]
2024-10-21 Further renaming #2
    [Main-PCB-v1.0.PcbDoc]
2025-01-31 #5 Schematic design completed.PCB in progress
    [Arc-Igniter-Sheet.SchDoc, Client-BOM-Main-PCB-v1.0.xlsx, Client-BOM-Secondary-PCB-v1.0.xlsx, Controller-Sheet.SchDoc, LED-Sheet.SchDoc, Main-PCB-v1.0.PcbDoc, Main-PCB-v1.1.PcbDoc, Main-PCB-v1.1.PrjPcb]
2025-02-03 #5 Placement in progress
    [Main-PCB-v1.1.PcbDoc, Main-PCB-v1.1.PrjPcb]
2025-02-04 #6 Placement done
    [Main-PCB-v1.1.PcbDoc, Main-PCB-v1.1.step]
2025-02-06 #6 Routing in progress
    [Controller-Sheet.SchDoc, Main-PCB-v1.1.PcbDoc, Main-PCB-v1.1.step]
2025-02-10 #6 placement in progress
    [Main-PCB-v1.1.PcbDoc, Secondary-PCB-v1.0.PcbDoc, Secondary-PCB-v1.1.PcbDoc, Secondary-PCB-v1.1.PrjPcb, Touch-Button-Sheet.SchDoc]
2025-02-13 #6 placement completed cad files and renderings added in deliverables folder
    [Main-PCB-v1.1.DWG, Main-PCB-v1.1.DXF, Main-PCB-v1.1.PcbDoc, Main-PCB-v1.1.step]
2025-02-19 #6 DRC and formatting remaining
    [Main-PCB-v1.1.PcbDoc, Main-PCB-v1.1.PrjPcb]
2025-02-20 #6 Routing completed drc error removed
    [Main-PCB-v1.1.PcbDoc]
2025-02-21 #6 Main and Secondary PCBs completed
    [Controller-Sheet.SchDoc, Main-PCB-v1.1.DWG, Main-PCB-v1.1.DXF, Main-PCB-v1.1.PcbDoc, Main-PCB-v1.1.step, Secondary-PCB-v1.1.DWG, Secondary-PCB-v1.1.DXF, Secondary-PCB-v1.1.PcbDoc]
2025-03-28 In Progress
    [Controller-Sheet.SchDoc, Power-Sheet.SchDoc]
2025-04-03 #5 Changes complete. Boost for 2 solenoids added. USB added PDF generated
    [Controller-Sheet.SchDoc, Main-PCB-v1.1.PrjPcb, Power-Sheet.SchDoc]
2025-04-08 Add: updated DXF file
    [Main PCB 7.3 Lighter.DXF, Secondary_PCB.step, Smart Lighter BOM.xlsx, Smart-Lighter-v1.0.step, electrical compartment version 5.DXF]
